go4retro/Fake6523/pcb/Fake6523.brd

## EAGLE design pcb/Fake6523.brd (2019-01-21)

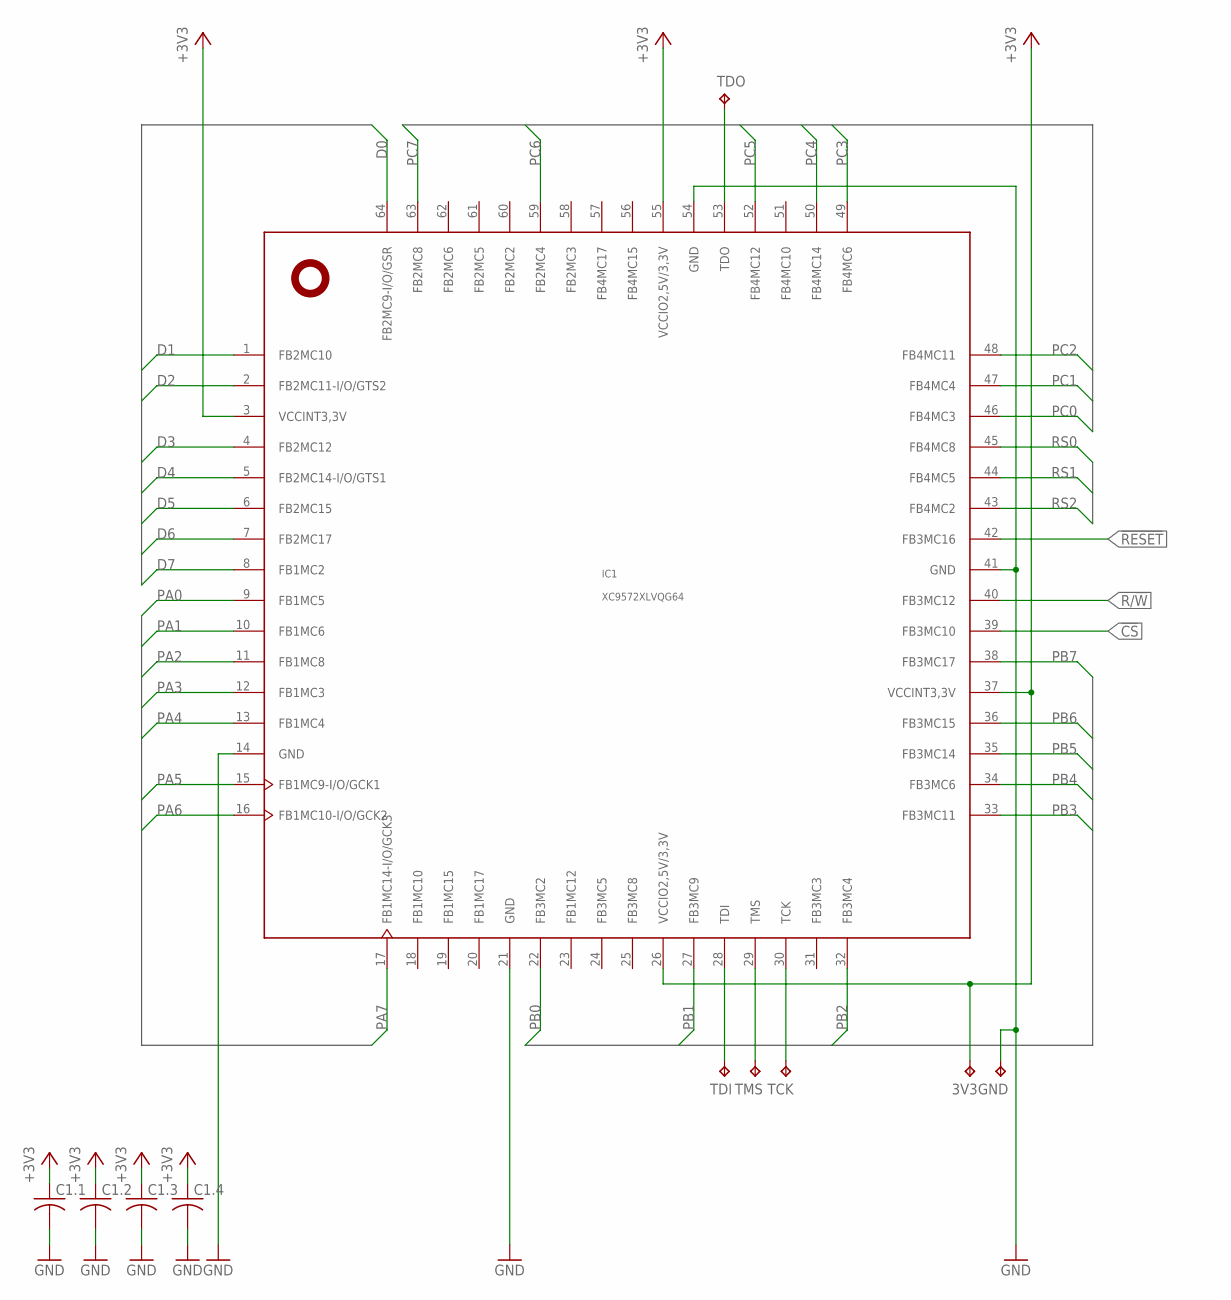
[picture p1: schematic Fake6523.sch, sheet 1, LOGIC]

Parts:
3V3: TPTP08R; TP08R
C1.1, C1.2, C1.3, C1.4: C-USC0402; C0402
GND: TPTP08R; TP08R
IC1: XC9572XLVQG64; VQFP64
TCK: TPTP08R; TP08R
TDI: TPTP08R; TP08R
TDO: TPTP08R; TP08R
TMS: TPTP08R; TP08R

Connections:
!CS: IC1.39 (FB3MC10); also elsewhere on the board
!RESET: IC1.42 (FB3MC16); also elsewhere on the board
+3V3: 3V3.TP, C1.1.1, C1.2.1, C1.3.1, C1.4.1, IC1.3 (VCCINT3,3V), IC1.26 (VCCIO2,5V/3,3V), IC1.37 (VCCINT3,3V), IC1.55 (VCCIO2,5V/3,3V); also elsewhere on the board
D0: IC1.64 (FB2MC9-I/O/GSR); also elsewhere on the board
D1: IC1.1 (FB2MC10); also elsewhere on the board
D2: IC1.2 (FB2MC11-I/O/GTS2); also elsewhere on the board
D3: IC1.4 (FB2MC12); also elsewhere on the board
D4: IC1.5 (FB2MC14-I/O/GTS1); also elsewhere on the board
D5: IC1.6 (FB2MC15); also elsewhere on the board
D6: IC1.7 (FB2MC17); also elsewhere on the board
D7: IC1.8 (FB1MC2); also elsewhere on the board
GND: C1.1.2, C1.2.2, C1.3.2, C1.4.2, GND.TP, IC1.14 (GND), IC1.21 (GND), IC1.41 (GND), IC1.54 (GND); also elsewhere on the board
PA0: IC1.9 (FB1MC5); also elsewhere on the board
PA1: IC1.10 (FB1MC6); also elsewhere on the board
PA2: IC1.11 (FB1MC8); also elsewhere on the board
PA3: IC1.12 (FB1MC3); also elsewhere on the board
PA4: IC1.13 (FB1MC4); also elsewhere on the board
PA5: IC1.15 (FB1MC9-I/O/GCK1); also elsewhere on the board
PA6: IC1.16 (FB1MC10-I/O/GCK2); also elsewhere on the board
PA7: IC1.17 (FB1MC14-I/O/GCK3); also elsewhere on the board
PB0: IC1.22 (FB3MC2); also elsewhere on the board
PB1: IC1.27 (FB3MC9); also elsewhere on the board
PB2: IC1.32 (FB3MC4); also elsewhere on the board
PB3: IC1.33 (FB3MC11); also elsewhere on the board
PB4: IC1.34 (FB3MC6); also elsewhere on the board
PB5: IC1.35 (FB3MC14); also elsewhere on the board
PB6: IC1.36 (FB3MC15); also elsewhere on the board
PB7: IC1.38 (FB3MC17); also elsewhere on the board
PC0: IC1.46 (FB4MC3); also elsewhere on the board
PC1: IC1.47 (FB4MC4); also elsewhere on the board
PC2: IC1.48 (FB4MC11); also elsewhere on the board
PC3: IC1.49 (FB4MC6); also elsewhere on the board
PC4: IC1.50 (FB4MC14); also elsewhere on the board
PC5: IC1.52 (FB4MC12); also elsewhere on the board
PC6: IC1.59 (FB2MC4); also elsewhere on the board
PC7: IC1.63 (FB2MC8); also elsewhere on the board
R/!W: IC1.40 (FB3MC12); also elsewhere on the board
RS0: IC1.45 (FB4MC8); also elsewhere on the board
RS1: IC1.44 (FB4MC5); also elsewhere on the board
RS2: IC1.43 (FB4MC2); also elsewhere on the board
TCK: IC1.30 (TCK), TCK.TP
TDI: IC1.28 (TDI), TDI.TP
TDO: IC1.53 (TDO), TDO.TP
TMS: IC1.29 (TMS), TMS.TP

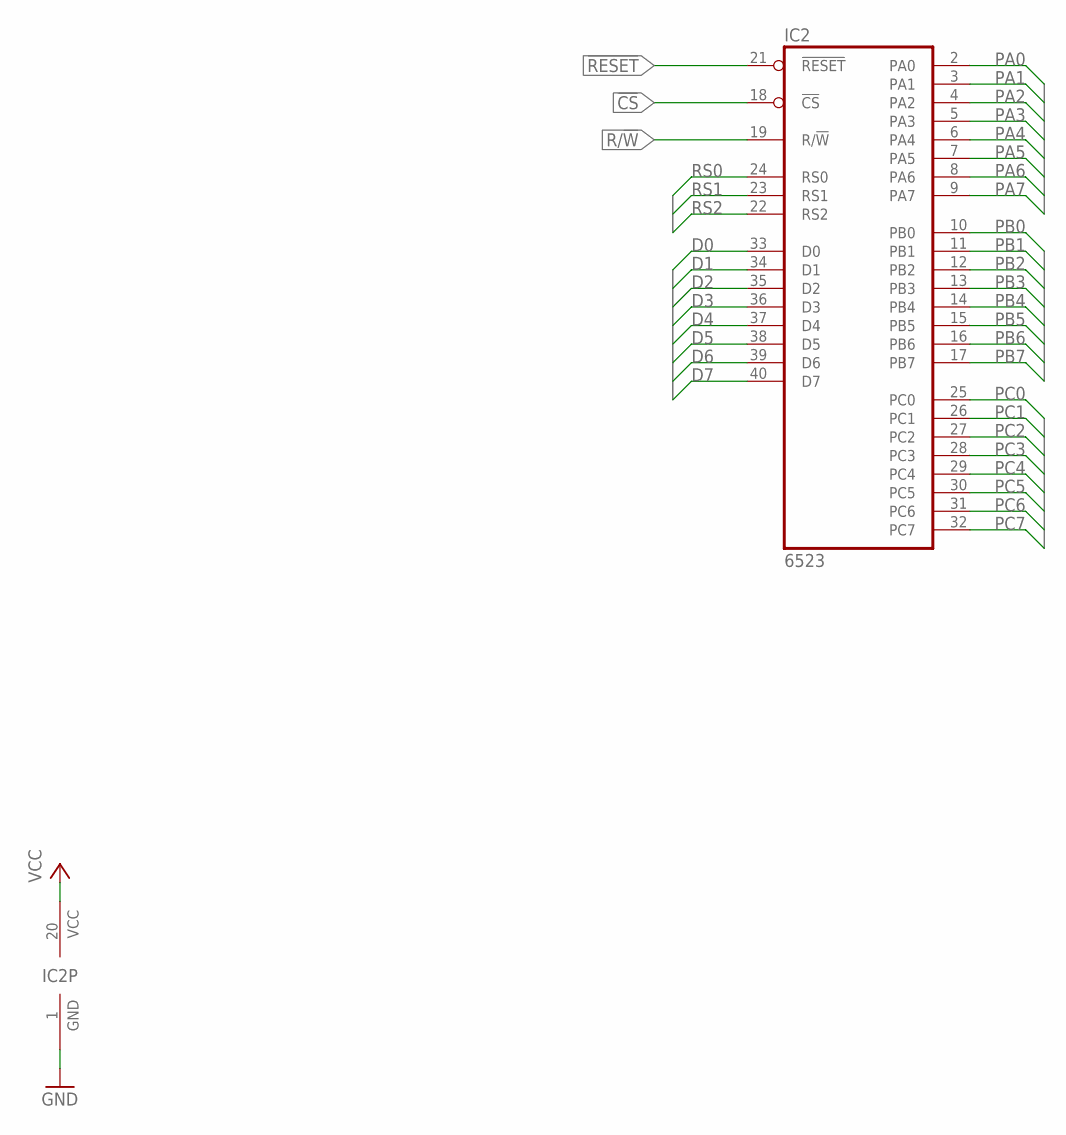
[picture p2: schematic Fake6523.sch, sheet 2, IO]

Parts:
IC2: 6523; DIL40-ROUNDPAD

Connections:
!CS: IC2.18 (!CS); also elsewhere on the board
!RESET: IC2.21 (!RESET); also elsewhere on the board
D0: IC2.33 (D0); also elsewhere on the board
D1: IC2.34 (D1); also elsewhere on the board
D2: IC2.35 (D2); also elsewhere on the board
D3: IC2.36 (D3); also elsewhere on the board
D4: IC2.37 (D4); also elsewhere on the board
D5: IC2.38 (D5); also elsewhere on the board
D6: IC2.39 (D6); also elsewhere on the board
D7: IC2.40 (D7); also elsewhere on the board
GND: IC2.1 (GND); also elsewhere on the board
PA0: IC2.2 (PA0); also elsewhere on the board
PA1: IC2.3 (PA1); also elsewhere on the board
PA2: IC2.4 (PA2); also elsewhere on the board
PA3: IC2.5 (PA3); also elsewhere on the board
PA4: IC2.6 (PA4); also elsewhere on the board
PA5: IC2.7 (PA5); also elsewhere on the board
PA6: IC2.8 (PA6); also elsewhere on the board
PA7: IC2.9 (PA7); also elsewhere on the board
PB0: IC2.10 (PB0); also elsewhere on the board
PB1: IC2.11 (PB1); also elsewhere on the board
PB2: IC2.12 (PB2); also elsewhere on the board
PB3: IC2.13 (PB3); also elsewhere on the board
PB4: IC2.14 (PB4); also elsewhere on the board
PB5: IC2.15 (PB5); also elsewhere on the board
PB6: IC2.16 (PB6); also elsewhere on the board
PB7: IC2.17 (PB7); also elsewhere on the board
PC0: IC2.25 (PC0); also elsewhere on the board
PC1: IC2.26 (PC1); also elsewhere on the board
PC2: IC2.27 (PC2); also elsewhere on the board
PC3: IC2.28 (PC3); also elsewhere on the board
PC4: IC2.29 (PC4); also elsewhere on the board
PC5: IC2.30 (PC5); also elsewhere on the board
PC6: IC2.31 (PC6); also elsewhere on the board
PC7: IC2.32 (PC7); also elsewhere on the board
R/!W: IC2.19 (R/!W); also elsewhere on the board
RS0: IC2.24 (RS0); also elsewhere on the board
RS1: IC2.23 (RS1); also elsewhere on the board
RS2: IC2.22 (RS2); also elsewhere on the board
VCC: IC2.20 (VCC); also elsewhere on the board

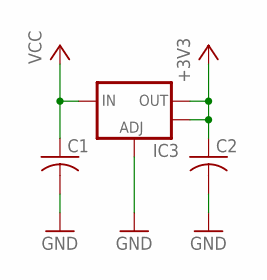
[picture p3: schematic Fake6523.sch, sheet 3, POWER]

Parts:
C1, C2: C-USC0805; C0805
IC3: V_REG_LM1117SOT223; SOT223

Connections:
+3V3: C2.1, IC3.2 (OUT), IC3.4 (OUT); also elsewhere on the board
GND: C1.2, C2.2, IC3.1 (ADJ); also elsewhere on the board
VCC: C1.1, IC3.3 (IN); also elsewhere on the board

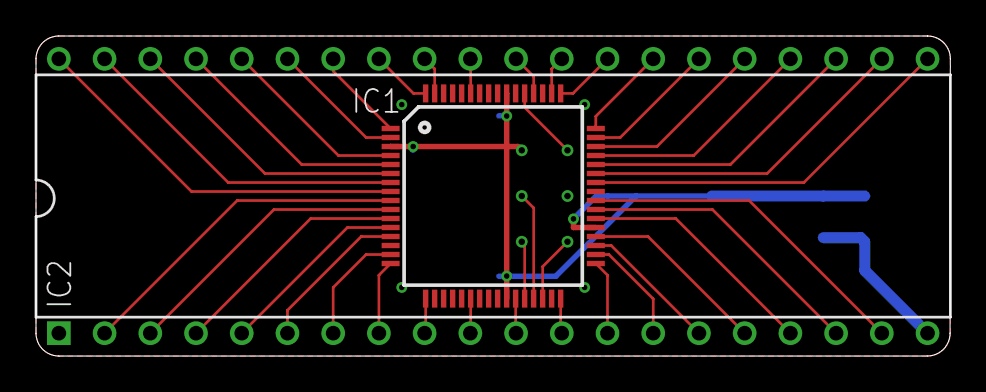
[picture p4: board Fake6523.brd from above]

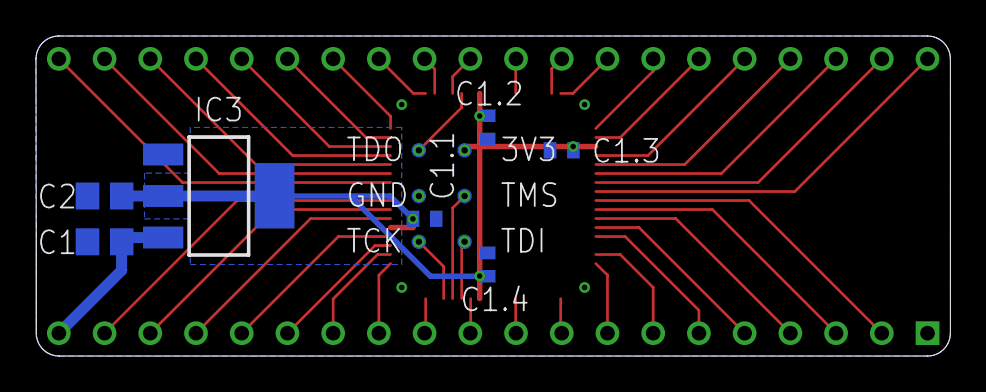
[picture p5: board Fake6523.brd from below]

Board: 2 copper layers, 50.8 x 17.8 mm, 15 parts (13 on the bottom side), 45 nets.
