go4retro/Fake6523/(commit log)

2019-01-21 Forgot a file
    [Fake6523.brd]
2019-01-21 Added UCF file and fixed lack of clock signal.
    [Fake6523.v]
